UserIsMissing/ECE-118_Robot/Electrical/TrackWireDetectorSchematic.pdf

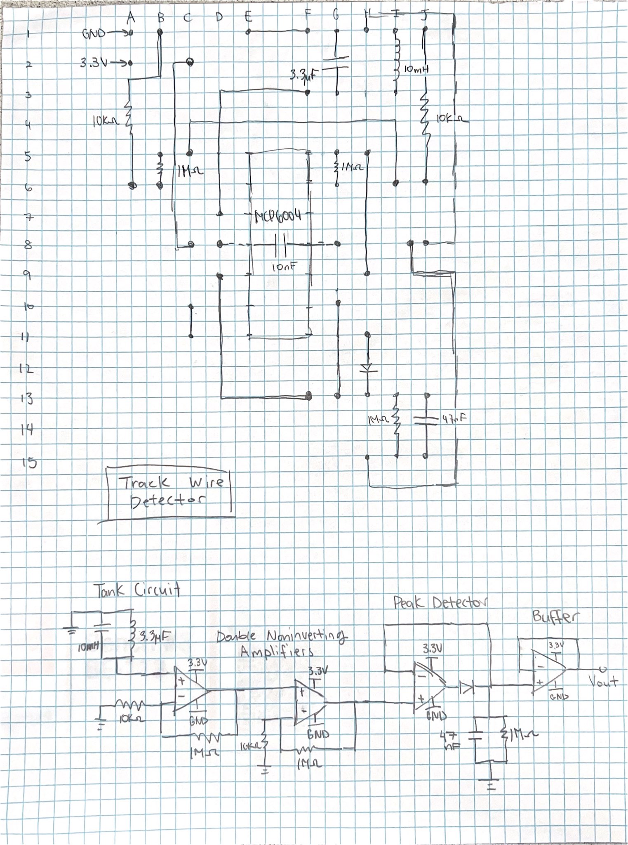
[picture p13: page 1]
