UserIsMissing/ECE-118_Robot/Images/6m0_Image_13.png

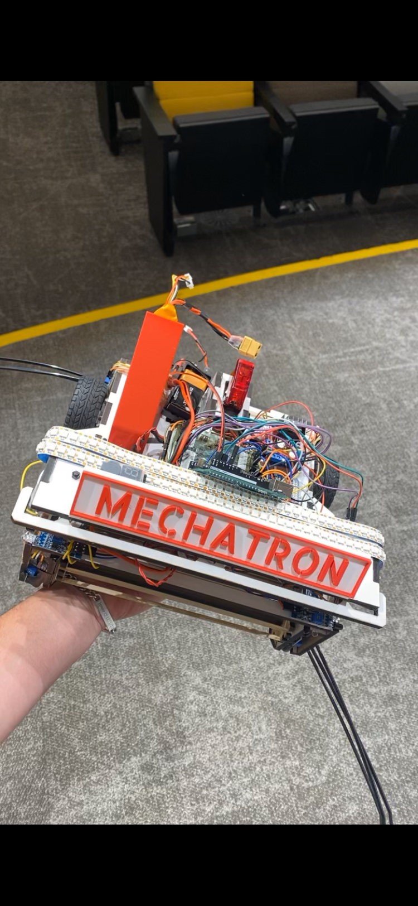
Images/6m0_Image_13.png
