UserIsMissing/ECE-118_Robot/Electrical/Robot_System_Design.pdf

FEI Iiii EE | iii i
III | Ige

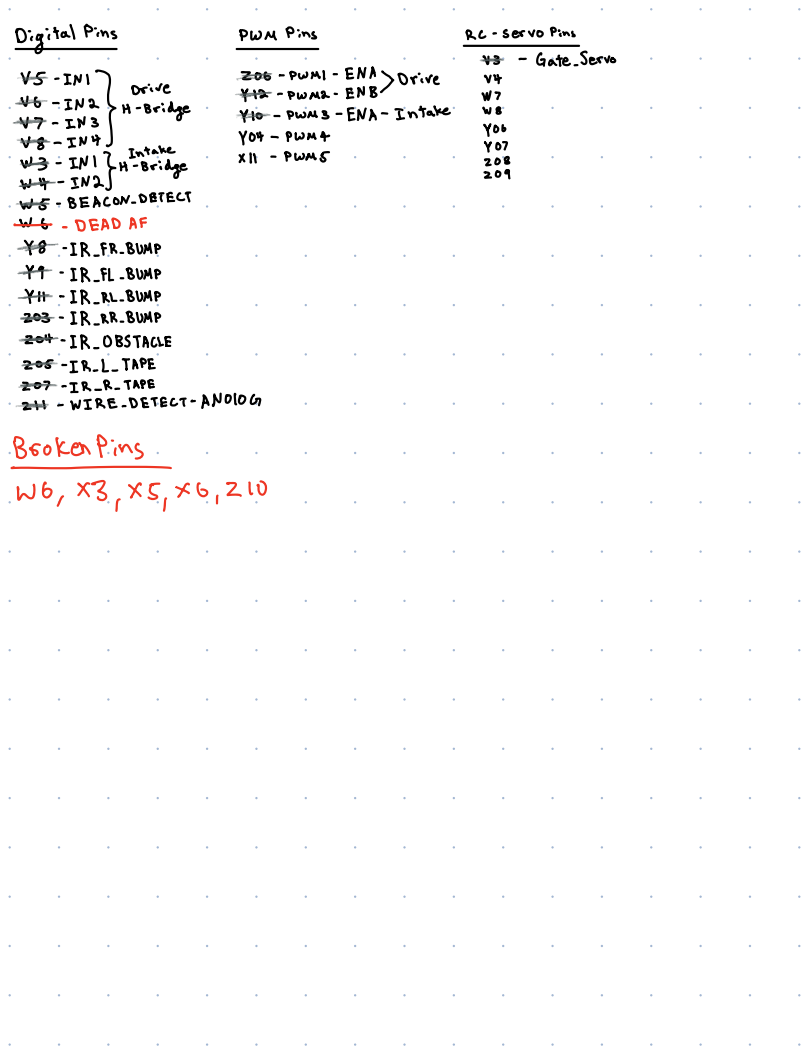
[picture p15: page 1]
DigitalPins; Pwa Pins; RC servoPins; 5 GateServo; 11 PWM5; iiiiiiiiiiiiiiiiiiiiiiiiiiiii.mn

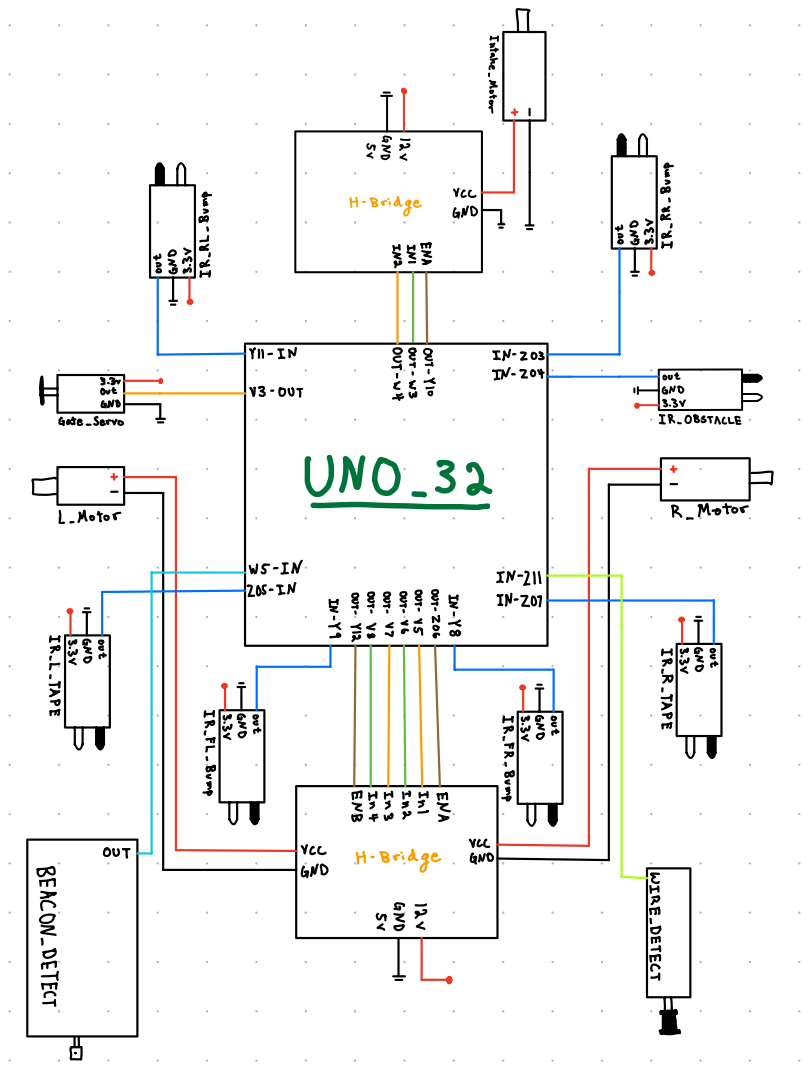
[picture p16: page 2]
if Bridge; V3OUT; L Motor; R Motor; OUT; H Bridge; Made
