UserIsMissing/ECE-118_Robot/(commit log)

2024-05-11 Motor & Switch Working
2024-05-13 Working Beacon Detector and IR Sensor
2024-05-13 Finished Testing Track Wire
2024-05-17 Still need to test IR sensor service from lab with 3.3v supply
2024-05-18 Got Events WORKING! time to add more sensors
2024-05-19 Still trying to get bitmask working
    saving before going to bed. im still sick
2024-05-20 WORKING: tape sensor bitmask works.
    Active low tape sensors. going to switch the logic with ! for wall IR sensors where its active HIGH when u see the wall
2024-05-20 All sensor evnts are created and working
2024-05-21 Wrote initial test states. still have to test
    Test states for moving forward and tape sensor stopping. ALSO, testing 5 second timer with print statements.
2024-05-22 IR sensors not working. IDK if its code or wires
2024-05-23 changed switch to if
2024-05-28 working nav (before back tape sensor)
2024-05-29 all events working!!! (mounted)
2024-06-01 small change. everything is reading as a tape sensor
2024-06-04 everything working smooth left wall ride
    restart timer sometimes doesnt work
2024-06-06 added LEDS
